GGGabri/DIY-Kick-Stompbox/stompbox_kick/sample_a.h

// Sound A for the DIY kick stompbox: 8-bit, 16 kHz, stored in flash
// Source: original synthesized acoustic kick, made for this pedal
#pragma once
#include <avr/pgmspace.h>

#define SAMPLE_A_RATE 16000UL
#define SAMPLE_A_LENGTH 5689UL

const uint8_t sampleA[SAMPLE_A_LENGTH] PROGMEM = {
  154, 105, 99, 120, 252, 102, 144, 187, 195, 163, 186, 140, 171, 206, 137, 230, 213, 241, 232, 152,
  174, 126, 206, 198, 217, 213, 200, 201, 181, 163, 206, 176, 136, 175, 187, 181, 221, 178, 165, 147,
  201, 142, 93, 173, 133, 195, 183, 162, 115, 102, 139, 105, 179, 106, 140, 144, 103, 114, 112, 129,
  131, 98, 106, 123, 98, 108, 133, 98, 108, 121, 114, 97, 129, 127, 96, 78, 100, 93, 89, 94,
  75, 91, 99, 80, 83, 73, 90, 74, 87, 76, 82, 83, 81, 77, 76, 75, 80, 94, 75, 76,
  68, 71, 65, 63, 72, 65, 56, 63, 60, 60, 59, 56, 65, 71, 52, 61, 54, 55, 56, 66,
  82, 74, 77, 69, 75, 67, 70, 71, 74, 84, 77, 84, 78, 76, 79, 79, 79, 74, 74, 74,
  85, 87, 85, 88, 84, 91, 84, 86, 88, 90, 94, 100, 98, 97, 94, 97, 99, 100, 99, 104,
  103, 100, 100, 101, 106, 105, 110, 110, 116, 117, 127, 129, 129, 134, 135, 139, 136, 139, 140, 141,
  139, 140, 144, 149, 151, 152, 156, 158, 156, 157, 157, 155, 155, 160, 168, 165, 167, 168, 172, 172,
  173, 172, 178, 177, 177, 178, 184, 185, 184, 177, 174, 171, 178, 180, 182, 183, 183, 182, 180, 177,
  180, 176, 173, 174, 178, 181, 182, 179, 176, 175, 177, 173, 171, 172, 174, 178, 177, 174, 169, 167,
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
  153, 152, 151, 150, 149, 148, 147, 146, 146, 145, 144, 143, 142, 142, 141, 140, 139, 138, 137, 136,
  136, 135, 134, 133, 132, 131, 131, 129, 128, 127, 126, 125, 124, 122, 121, 120, 119, 118, 116, 115,
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
};
