GGGabri/DIY-Kick-Stompbox/stompbox_kick/sample_b.h

// Sound B for the DIY kick stompbox: 808-style kick, 8-bit, 16 kHz, stored in flash
// Source: rendered from the pedal's own 808 synth (160 -> 50 Hz sweep)
#pragma once
#include <avr/pgmspace.h>

#define SAMPLE_B_RATE 16000UL
#define SAMPLE_B_LENGTH 4089UL

const uint8_t sampleB[SAMPLE_B_LENGTH] PROGMEM = {
  133, 143, 149, 158, 164, 173, 178, 187, 192, 200, 205, 212, 216, 222, 226, 232, 236, 238, 242, 245,
  247, 249, 250, 251, 252, 251, 251, 250, 249, 246, 245, 241, 239, 235, 231, 228, 222, 218, 212, 207,
  201, 195, 190, 182, 176, 168, 163, 157, 148, 143, 133, 128, 122, 112, 107, 98, 93, 87, 79, 74,
  68, 61, 56, 52, 45, 41, 36, 32, 29, 24, 22, 20, 16, 14, 13, 12, 11, 10, 10, 10,
  11, 11, 13, 16, 16, 19, 22, 25, 28, 32, 36, 40, 44, 50, 54, 58, 63, 70, 76, 81,
  86, 94, 100, 105, 110, 119, 125, 130, 136, 144, 150, 155, 161, 166, 173, 178, 184, 188, 192, 199,
  203, 207, 211, 214, 218, 222, 225, 227, 229, 231, 234, 236, 237, 238, 238, 239, 238, 238, 237, 236,
  236, 233, 232, 230, 228, 224, 222, 219, 216, 212, 208, 205, 201, 197, 190, 186, 181, 176, 171, 167,
  162, 156, 151, 146, 141, 133, 128, 122, 117, 111, 106, 101, 96, 91, 86, 82, 77, 73, 68, 64,
  60, 56, 53, 49, 46, 43, 39, 37, 34, 31, 30, 27, 27, 25, 24, 24, 23, 23, 23, 23,
  24, 24, 25, 27, 28, 30, 32, 34, 37, 39, 41, 45, 48, 51, 55, 59, 62, 66, 70, 75,
  79, 84, 88, 93, 98, 100, 105, 110, 115, 120, 125, 130, 135, 140, 145, 150, 154, 157, 161, 166,
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
  161, 162, 164, 165, 166, 167, 169, 169, 171, 172, 173, 174, 175, 177, 177, 178, 179, 179, 181, 181,
  181, 182, 183, 183, 183, 184, 184, 185, 185, 185, 185, 186, 186, 185, 185, 185, 185, 185, 185, 185,
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
};
